leon-thomm/nus-cs3237-iot-buoys/dataset/img/data-aggregated.png

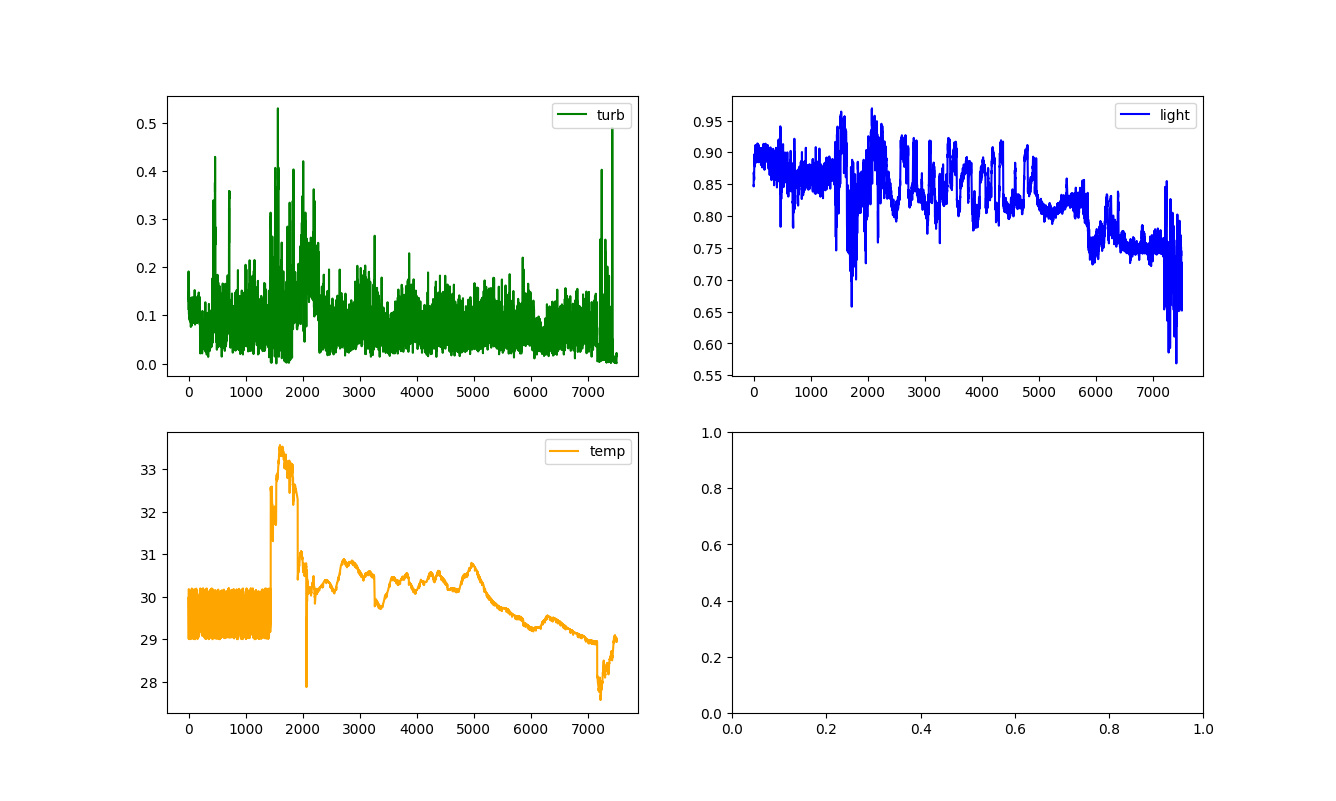
dataset/img/data-aggregated.png
