leon-thomm/nus-cs3237-iot-buoys/dataset/img/data-before.png

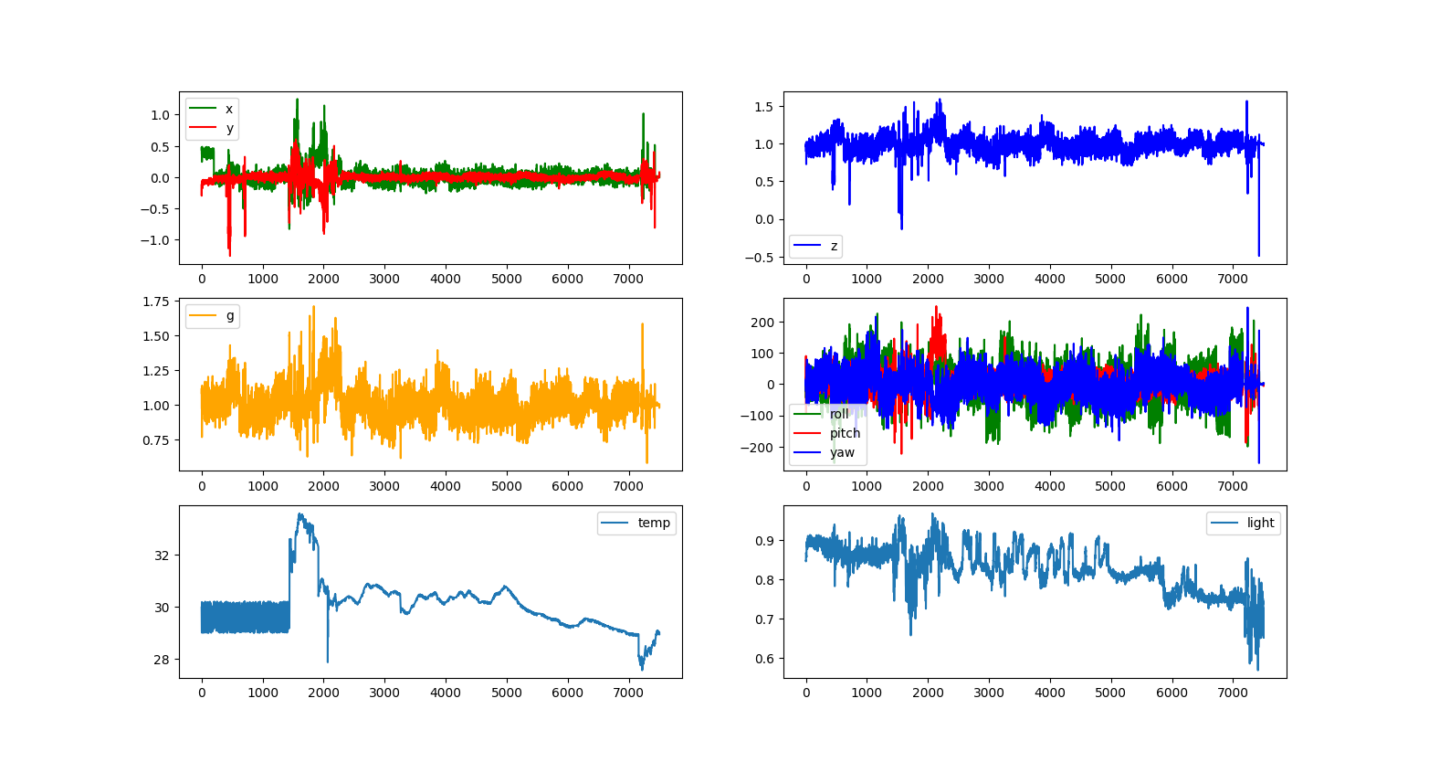
dataset/img/data-before.png
