leon-thomm/nus-cs3237-iot-buoys/report/data-moderated.png

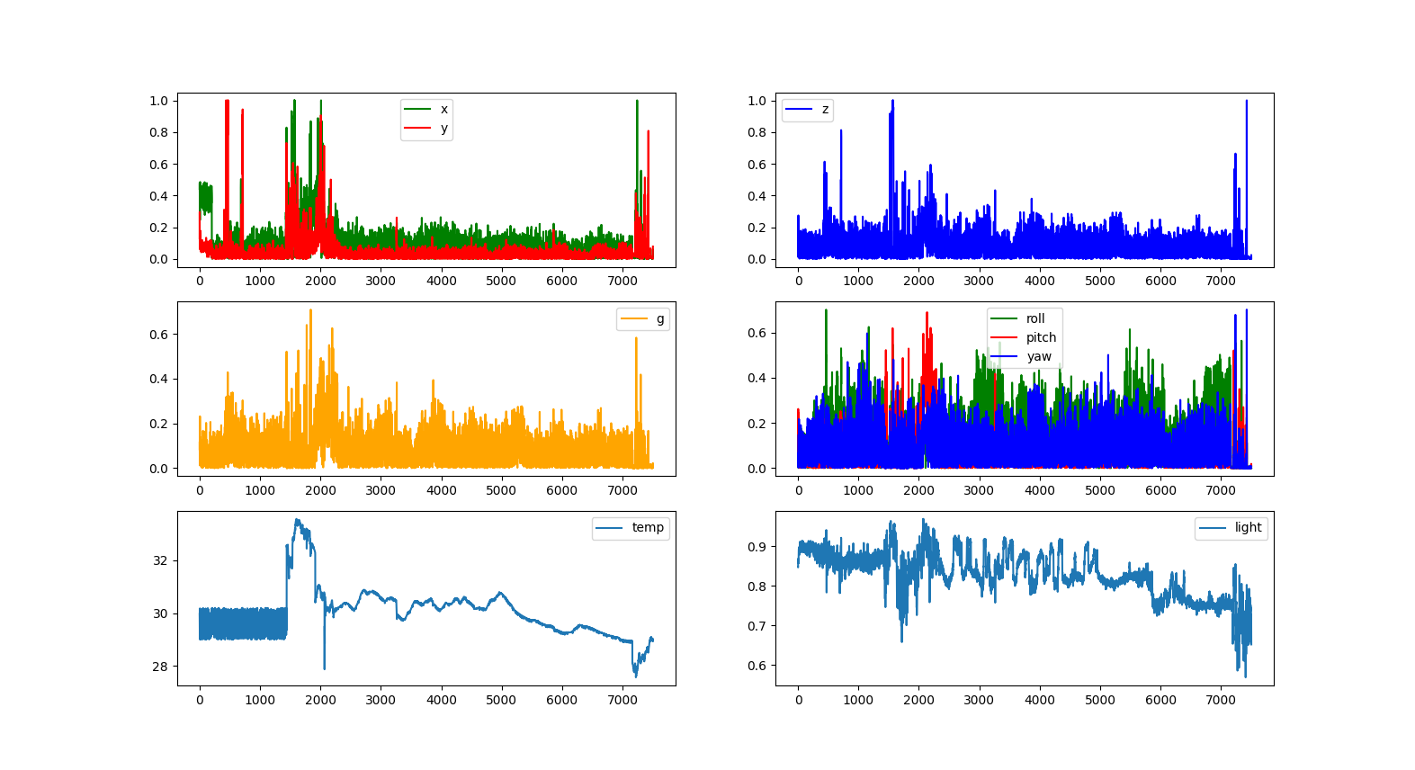
report/data-moderated.png
