leon-thomm/nus-cs3237-iot-buoys/report/images/accelerometerdata.png

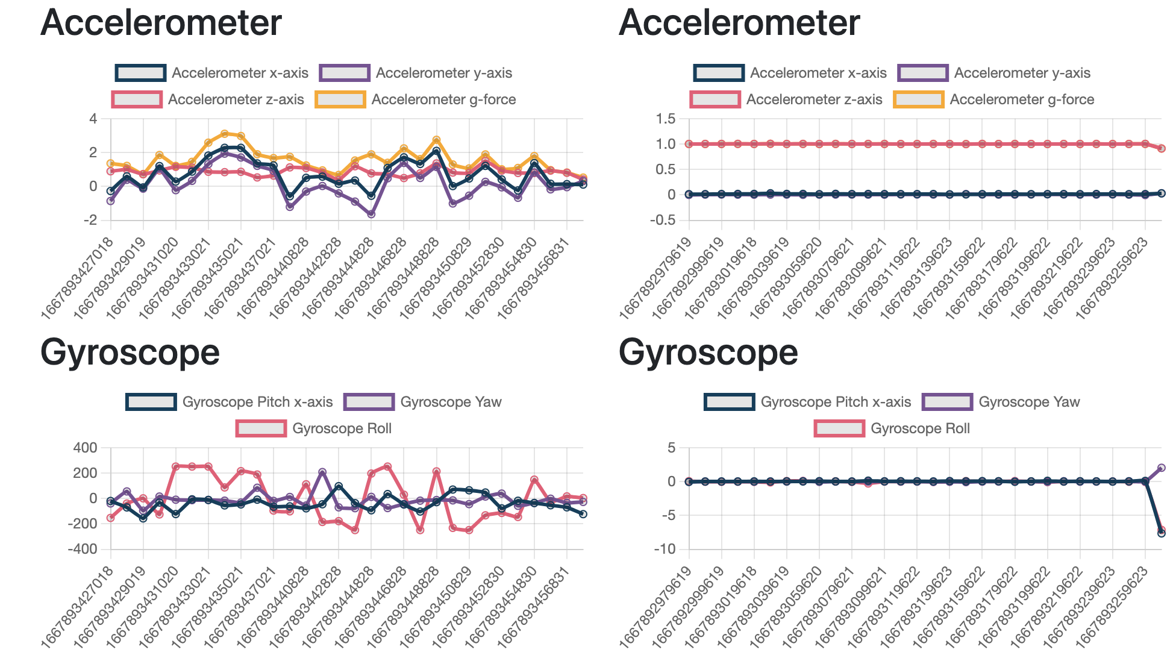
report/images/accelerometerdata.png
