leon-thomm/nus-cs3237-iot-buoys/report/images/alternative_phone_wemos.png

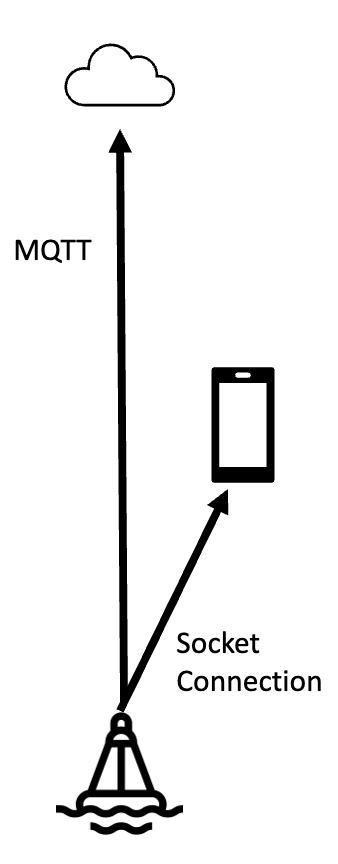
report/images/alternative_phone_wemos.png
