leon-thomm/nus-cs3237-iot-buoys/report/images/buoy1-2.png

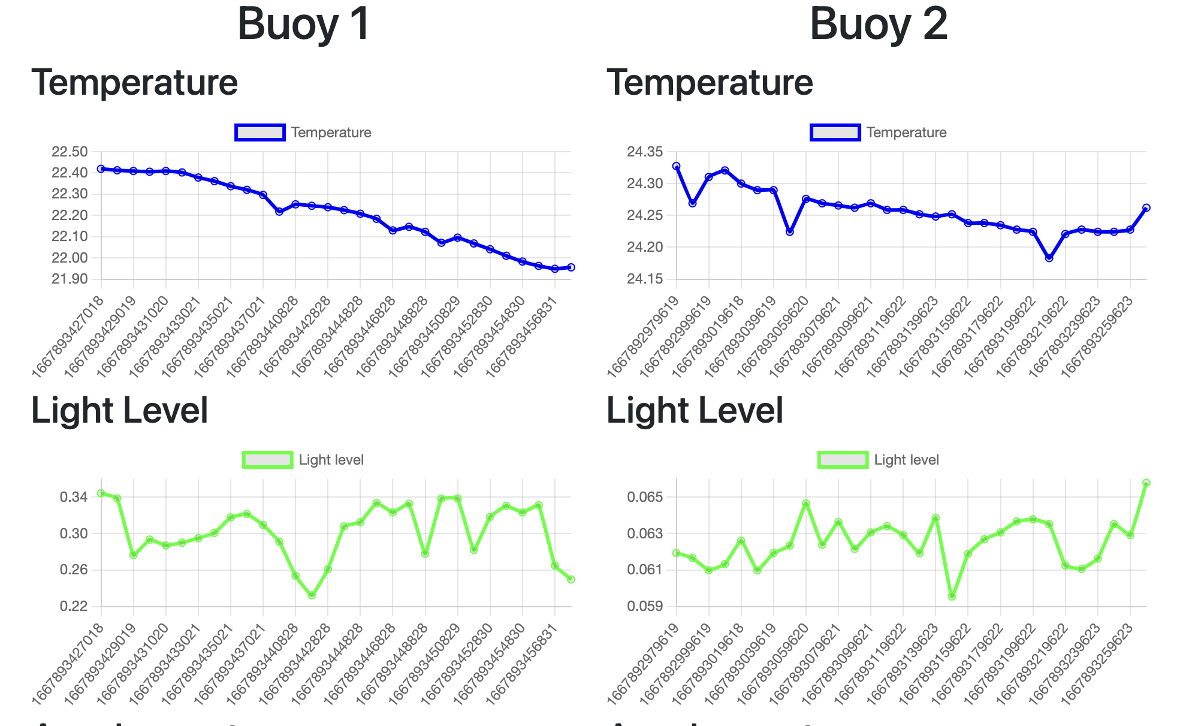
report/images/buoy1-2.png
