leon-thomm/nus-cs3237-iot-buoys/report/images/buoy-top-view-with-battery.jpg

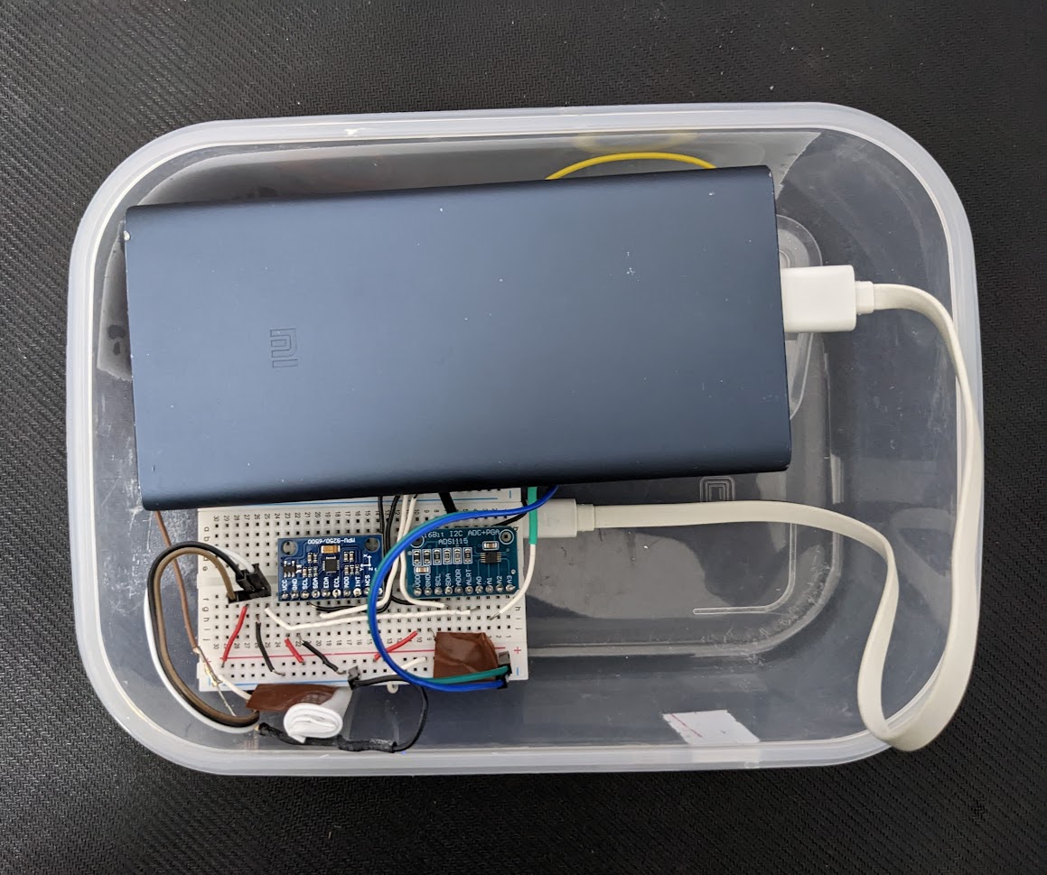
report/images/buoy-top-view-with-battery.jpg
