leon-thomm/nus-cs3237-iot-buoys/report/images/west_coast_park.png

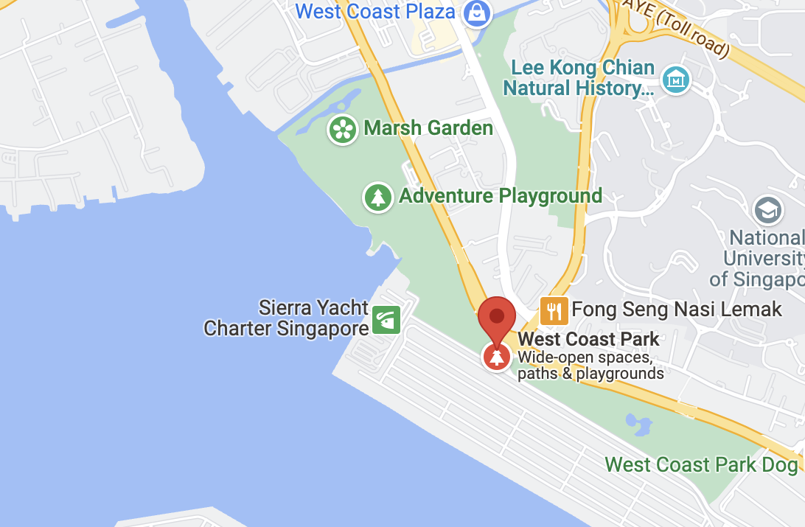
report/images/west_coast_park.png
