leon-thomm/nus-cs3237-iot-buoys/(commit log)

2022-10-11 MPU9250 test [broken]
    couldn't not get this working so far, I get random console output, monitor configuration seems correct
    [test1.ino]
2022-10-19 Final Clean Up before adding camera
2022-10-19 Add code for LED/LDR modules
2022-10-19 Adding inital Camera and Torch Support
2022-10-20 temperature sensor
2022-10-20 i2c lib
2022-10-20 reading temperature and photoresistor via adc over i2c
2022-10-24 Removing everything camera related
2022-10-24 Ready for Debug Currently usng the accelerometer from phone Photoresistor and temperature is dummy data Timestamp is used from the phone
2022-10-24 parameterize MPU I2C address
2022-10-24 fix temperature calculation to work with values adc
2022-10-24 reworked adc
    Now using a library. I ran into issues when trying to configure it manually, I could not select the channels correctly anymore and had to be very careful with access frequencies. The library seems to work better so far.
2022-10-24 Fixing DataClass and Main Dart for Checkin2 Adding Gyro and Accelerometer List in DataClass Fixing publishData bug that same data gets pushed multiple times. Publish Data handels disconnected state H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
2022-10-24 new main program
    successfully collects data from all sensors (including both I2C devices) and send to phone over HTTP
2022-11-01 Removing Accelerometer
2022-11-04 Cleaned and merged dataset from 03/04 nov collection
    [03nov.csv, 04nov.csv, data.csv]
2022-11-05 remove data collected after 1710
    [04nov.csv]
2022-11-05 Fixed timestamp truncation
    [data.csv]
2022-11-06 control LED
2022-11-06 Add single-variable, multi step LSTM predictor
    [data.csv, data1.csv, predict.csv]
2022-11-07 revert changes mostly to deployment version
    the sending works, but the serial output is broken
    [buoy_wemos.ino]
2022-11-07 scheduler slots fix
2022-11-07 Added and refined scripts, added visualisation for test data
    [data-aggregated.csv, data-moderated.csv]
2022-11-07 Clean up ML training datasets
    [data-aggregated.csv, data.csv, data1.csv, predict.csv]
2022-11-15 architecture, hardware, power modes, I2C
2022-11-18 Add code for DIY turbidity sensor PoC experiment
